Dorsel89/phyphox-mini-pcb-II/README.md

# phyphox mini – Hardware

KiCad-Projekt (Schaltplan, Layout, Projektbibliothek) für das phyphox-mini-Board.

## Lizenz

Copyright phyphox:tools 2026.

Dieses Hardware-Design ist unter der **CERN Open Hardware Licence Version 2 –
Strongly Reciprocal (CERN-OHL-S-2.0)** lizenziert; der vollständige Text steht in
[LICENSE](LICENSE).

```
SPDX-License-Identifier: CERN-OHL-S-2.0
```

Source Location: <!-- URL des öffentlichen Repositorys eintragen -->

Du darfst dieses Design gemäß CERN-OHL-S-2.0 weiterverbreiten und verändern.
Es wird OHNE JEDE AUSDRÜCKLICHE ODER STILLSCHWEIGENDE GEWÄHRLEISTUNG
bereitgestellt, einschließlich der Marktgängigkeit, der zufriedenstellenden
Qualität und der Eignung für einen bestimmten Zweck. Die anwendbaren
Bedingungen stehen in der CERN-OHL-S v2.

Wenn du Produkte auf Basis dieses Designs vertreibst, musst du gemäß
Abschnitt 4 der Lizenz die zugehörige Quelle (Source) offenlegen, auch die
deiner Änderungen.

### Ausnahmen

- **Abgeleitete KiCad-Bibliothekselemente:** Die Footprints
  `Sensirion_DFN-4_1.5x1.5mm_P0.8mm_SHT4x_NoCentralPad` und
  `Texas_SWRA117D_2.4GHz_Right_Pad2-0.65mm` sowie das Symbol `BMI423` in
  [lib/](lib/) stehen unter CC-BY-SA 4.0 (© KiCad Library Team). Details
  stehen in [lib/README.md](lib/README.md).
- **Namen und Logos** sind von der Lizenz ausgenommen. Die Lizenz gewährt
  keine Rechte, sie für eigene Produkte zu verwenden.
