Dorsel89/phyphox-mini-pcb-II/BOM-phyphox-mini-pcb_v2.csv

Reference | MPN | Qty | Value | DNP | Exclude from BOM | Exclude from Board | Footprint | Datasheet | Spec | LCSC | Hersteller-Teilenummer | Alternative | Farnell PN | TME PN | Alternative MPN | Mouser PN | DigiKey PN
C1,C2 | GMC02X5R225K6R3NT | 2 | 2.2µF |  |  |  | phyphox-mini:C_0201_0603Metric_Nordic |  | X5R 10V |  |  |  |  |  |  |  | 4713-GMC02X5R225K6R3NTCT-ND
C3 | GRM155R60J106ME05D | 1 | 10µF |  |  |  | Capacitor_SMD:C_0402_1005Metric |  | X5R 6.3V |  |  |  | 3582794 | GRM155R60J106ME15D | GRM155C80J106ME11D | 81-GRM155R60J106ME5D | 490-13238-1-ND
C4,C7,C8,C10 | GRM033R61A104KE15D | 4 | 100nF |  |  |  | phyphox-mini:C_0201_0603Metric_Nordic |  | X5R 10V,X5R 10V, optional |  |  |  | 2470450 | GRM033R61A104KE15D |  | 81-GRM033R61A104KE5D | 490-5881-1-ND
C5 | GRM033R71A222KA01D | 1 | 2.2nF |  |  |  | phyphox-mini:C_0201_0603Metric_Nordic |  | X7R 10V |  |  |  | 2999376 | GRM033R71A222KA01D |  | 81-GRM033R71A222KA1D | 490-6144-1-ND
C6 | GJM0335C1E1R5WB01D | 1 | 1.5pF |  |  |  | phyphox-mini:C_0201_0603Metric_Nordic |  |  |  |  |  | 3243178 | GJM0335C1E1R5WB01D |  | 81-GJM0335C1E1R5WB1J | 490-11176-1-ND
C9 | GJM0335C1E2R0WB01D | 1 | 2.0pF |  |  |  | phyphox-mini:C_0201_0603Metric_Nordic |  |  |  |  |  | 3346165 | GJM0335C1E2R0WB01D |  | 81-GJM0335C1E2R0WB1D | 490-12592-1-ND
C11 | GRM0335C1HR30BA01D | 1 | 0.3pF |  |  |  | phyphox-mini:C_0201_0603Metric_Nordic |  | NP0 ±0.05pF |  |  |  | 2998785 | GRM0335C1HR30BA01D |  | 81-GRM0335C1HR30BA1D | 490-6135-1-ND
C12 | GRM033R70J103KA01D | 1 | 10nF |  |  |  | phyphox-mini:C_0201_0603Metric_Nordic |  | X7R 6.3V |  |  |  | 2611886 | GRM033R70J103KA01D |  | 81-GRM033R70J103KA1D | 490-1262-1-ND
C13 | GJM0335C1H3R9WB01D | 1 | 3.9pF |  |  |  | phyphox-mini:C_0201_0603Metric_Nordic |  | NP0 ±0.05pF 50V |  |  |  |  |  | GJM0333C1E3R9WB01D | 81-GJM0335C1H3R9WB1D | 490-GJM0335C1H3R9WB01DCT-ND
C20 | CL21A476MQYNNNE | 1 | 47µF |  |  |  | Capacitor_SMD:C_0805_2012Metric |  | X5R 6.3V, Puffer für Pulsströme | C16780 |  |  | 4539107 | CL21A476MQYNNNE |  | 187-CL21A476MQYNNNE
C21,C22 |  | 2 | DNP | Nicht bestücken |  |  | Capacitor_SMD:C_0402_1005Metric |  | Antennen-Tuning, nicht bestückt
C30,C31,C32,C33,C34,C35 | GRM155R71C104KA88D | 6 | 100nF |  |  |  | Capacitor_SMD:C_0402_1005Metric |  | X7R 16V |  |  |  | 4326786 | GRM155R71C104KA88D |  | 81-GRM155R71C104KA88 | 490-6328-1-ND
D1 |  | 1 | LED |  |  |  | LED_SMD:LED_0603_1608Metric
FB1 | BLM03AG121SN1D | 1 | 120R@100MHz |  |  |  | phyphox-mini:L_0201_0603Metric_Nordic |  | 200 mA, 0.5 Ohm max |  |  |  | 1400872 | BLM03AG121SN1D |  | 81-BLM03AG121SN1D | 490-2557-1-ND
L1 | MLZ1608M4R7WT000 | 1 | 4.7µH |  |  |  | phyphox-mini:L_0603_1608Metric_Nordic |  | 120 mA, 0.65 Ohm, ±20% |  |  |  | 2215636 |  |  | 810-MLZ1608M4R7WT000 | 445-6390-1-ND
L2 | LQP03HQ2N7B02D | 1 | 2.7nH |  |  |  | phyphox-mini:L_0201_0603Metric_Nordic |  |  |  |  |  | 2871309 | LQP03HQ2N7B02D |  | 81-LQP03HQ2N7B02D | 490-13909-1-ND
L3,L4 | LQP03HQ3N5B02D | 2 | 3.5nH |  |  |  | phyphox-mini:L_0201_0603Metric_Nordic |  |  |  |  |  | 3355000 |  |  | 81-LQP03HQ3N5B02D | 490-13925-1-ND
R1 | RC0201FR-071KL | 1 | 1k |  |  |  | phyphox-mini:R_0201_0603Metric_Nordic |  |  |  |  |  | 1856995 | RC0201FR-071KL |  | 603-RC0201FR-071KL | 13-RC0201FR-131KLCT-ND
R2 | RC0402JR-070RL | 1 | 0R |  |  |  | Resistor_SMD:R_0402_1005Metric |  | Antennen-Tuning (0 Ohm / L / C) |  |  |  | 9232516 | RC0402JR-070R |  | 603-RC0402JR-070RL
R3 | RC0402FR-071KL | 1 | 1k |  |  |  | Resistor_SMD:R_0402_1005Metric |  |  |  |  |  | 9239235 | RC0402FR-071KL |  | 603-RC0402FR-071KL | 311-1.00KLRCT-ND
R10,R11 | RC0402FR-0710KL | 2 | 10k |  |  |  | Resistor_SMD:R_0402_1005Metric |  |  |  |  |  | 9239359 |  |  | 603-RC0402FR-0710KL | 311-10.0KLRCT-ND
U1 | NRF54L15-QFAA-R | 1 | nRF54L15-QFAA |  |  |  | phyphox-mini:nRF54L15-QFAA_QFN-48-1EP_6x6mm_P0.4mm | https://docs.nordicsemi.com/bundle/ps_nrf54L15/page/keyfeatures_html5.html |  |  |  |  | 4544025 |  |  | 949-NRF54L15-QFAA-R | 4823-NRF54L15-QFAA-RCT-ND
U2 | BMI423 | 1 | BMI423 |  |  |  | Package_LGA:Bosch_LGA-14_3x2.5mm_P0.5mm | https://www.bosch-sensortec.com/media/boschsensortec/downloads/datasheets/bst-bmi423-ds000.pdf |  |  |  |  |  |  |  | 262-BMI423
U3 | BMP581 | 1 | BMP581 |  |  |  | phyphox-mini:BMP581_LGA-10_2x2mm_P0.5mm | https://www.bosch-sensortec.com/media/boschsensortec/downloads/datasheets/bst-bmp581-ds004.pdf |  |  |  |  |  |  |  |  | 828-BMP581CT-ND
U4 | STCC4-D-R3 | 1 | STCC4 |  |  |  | phyphox-mini:STCC4_LGA-8_3x4mm | https://sensirion.com/media/documents/6AED4B15/69295E41/CD_DS_STCC4_D1.pdf |  |  |  |  |  |  |  | 403-STCC4-D-R3 | 1649-STCC4-D-R3CT-ND
U5 | SHT40-AD1B-R3 | 1 | SHT40-AD1B |  |  |  | phyphox-mini:Sensirion_DFN-4_1.5x1.5mm_P0.8mm_SHT4x_NoCentralPad | https://sensirion.com/media/documents/33FD6951/6A7C10A0/HT_DS_Datasheet_SHT4x_V7.3.pdf |  |  |  |  | 3586476 | SHT40AD1BR3-SEN-0 |  | 403-SHT40-AD1B-R3 | 1649-SHT40-AD1B-R3CT-ND
X1 | CM8V-T1A-32.768KHZ-9PF-20PPM-TB-QA | 1 | 32.768kHz |  |  |  | Crystal:Crystal_SMD_MicroCrystal_CC8V-T1A-2Pin_2.0x1.2mm |  | CL=9pF, ±20ppm |  |  |  |  |  |  |  | 2195-CM8V-T1A-32.768KHZ-9PF-20PPM-TB-QACT-ND
X2 | ABM11W-32.0000MHZ-8-D1X-T3 | 1 | 32MHz |  |  |  | Crystal:Crystal_SMD_2016-4Pin_2.0x1.6mm |  | CL=8pF, ±40ppm gesamt | C718072 |  |  | 3573167 | ABM11W32.0000M-2 | X201632MKB4SI (YXC) | 815-11W32-8D1XT | 535-13900-1-ND
