Dorsel89/phyphox-mini-pcb-II/(commit log)

2026-11-02 pcb guidelines implemented
2026-11-02 reference circuit implemented
2026-11-02 added sensors and 3d models
2026-11-03 added UART Testpoint and fixed BMP Footprint
2026-11-09 changed battery connector
2026-11-13 added BOM and Gerber
